soroush-ab/pebble/digital_twin/twin/web/meshes/yaw_shell.stl

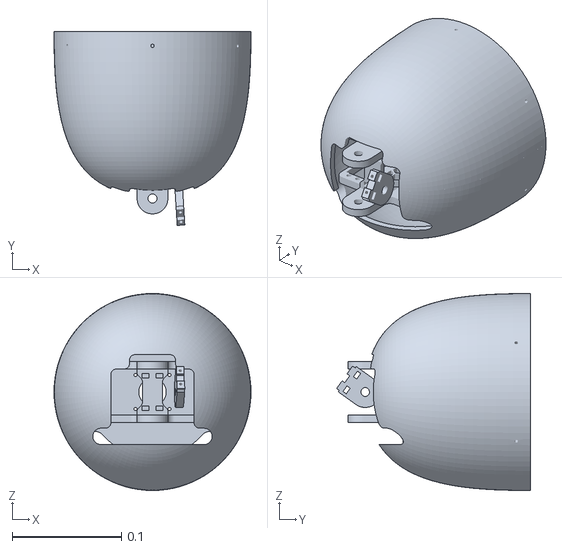
[picture p1: CAD file, 2026-10-13]
digital_twin/twin/web/meshes/yaw_shell.stl
0.18 x 0.177 x 0.18
