soroush-ab/pebble/digital_twin/twin/web/meshes/pitch_shell.stl

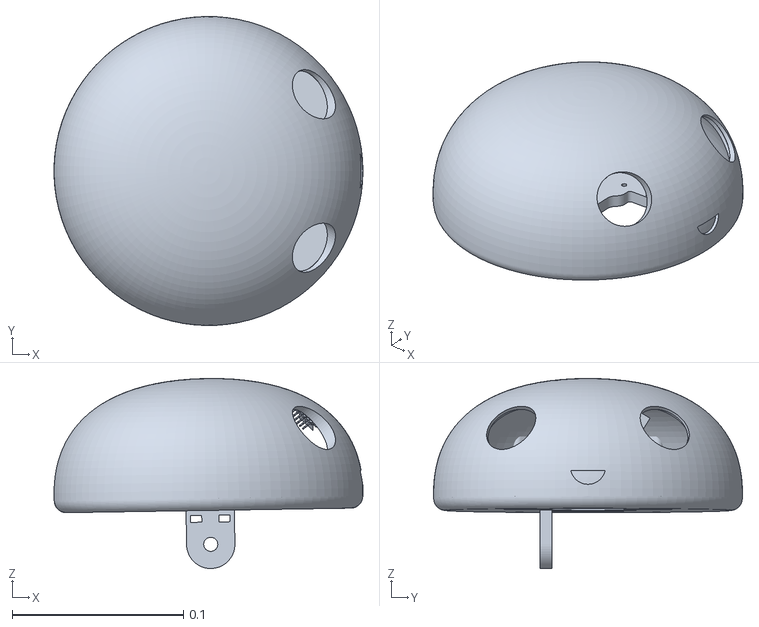
[picture p2: CAD file, 2026-10-13]
digital_twin/twin/web/meshes/pitch_shell.stl
0.18 x 0.18 x 0.111
