soroush-ab/pebble/digital_twin/twin/web/meshes/yaw_internal.stl

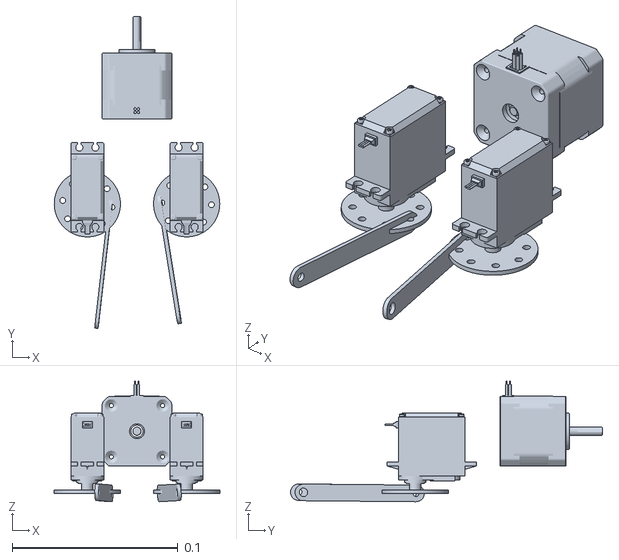
[picture p3: CAD file, 2026-10-13]
digital_twin/twin/web/meshes/yaw_internal.stl
0.1 x 0.188 x 0.0728
