soroush-ab/pebble/digital_twin/twin/web/meshes/roll_internal.stl

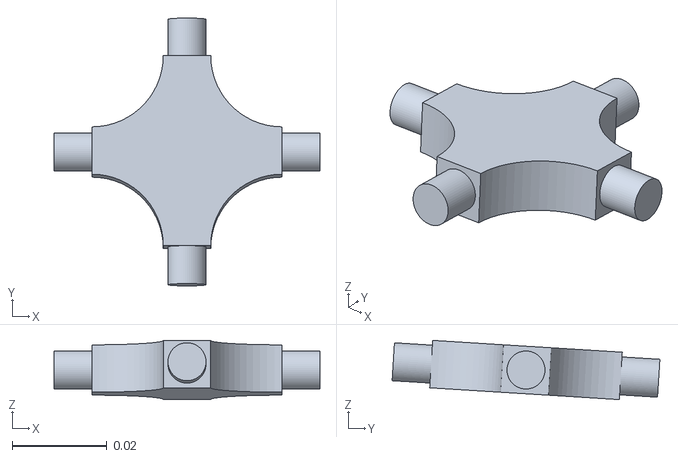
[picture p4: CAD file, 2026-10-13]
digital_twin/twin/web/meshes/roll_internal.stl
0.056 x 0.0564 x 0.0125
