soroush-ab/pebble/digital_twin/twin/web/meshes/pitch_internal.stl

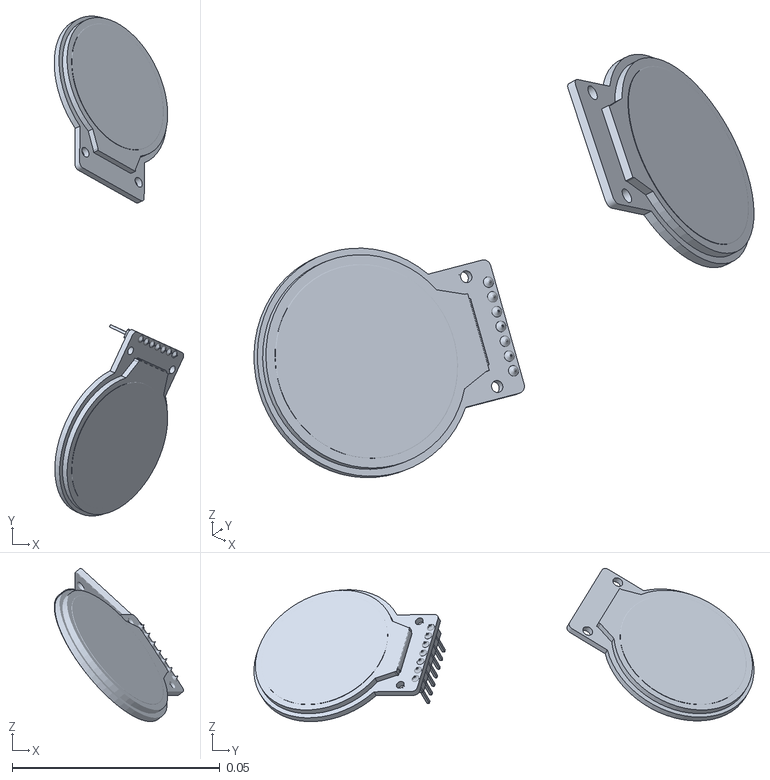
[picture p5: CAD file, 2026-10-13]
digital_twin/twin/web/meshes/pitch_internal.stl
0.0312 x 0.12 x 0.0369
