soroush-ab/pebble/digital_twin/twin/web/meshes/base_shell.stl

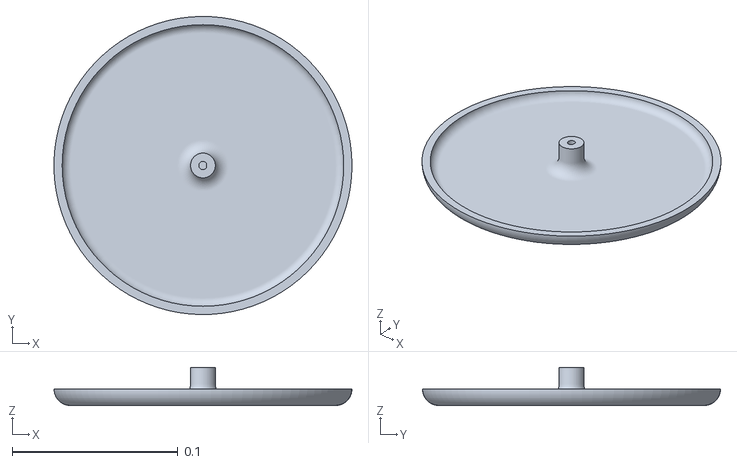
[picture p6: CAD file, 2026-10-13]
digital_twin/twin/web/meshes/base_shell.stl
0.18 x 0.18 x 0.023
