soroush-ab/pebble/(commit log)

2026-10-07 Add TTS, mic input, HTTP service and hardware-based model choice to speech
    - stt.py: model "auto" picks by hardware (GPU -> medium.en-q5_0, 8+ core
    CPU -> small.en-q5_1, otherwise base.en-q5_1), threads capped at 4;
    transcribe() takes numpy (+sample_rate), audio file bytes or a path;
    --mic push-to-talk with --save-dir / --input-device; collapses repeated
    sentences; models download atomically (a half-downloaded model used to
    segfault).
    - tts.py + voices.json: local Piper TTS with one voice/speed per LLM1
    character_id, extraversion-based speed for unlisted characters.
    - server.py: stdlib HTTP service (POST /stt, POST /tts, GET /health) so
    the robot, Home Assistant or the LLM pipe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
2026-10-11 Add digital twin, Russell emotions
    [robot.yaml]
2026-10-13 Retune Marvin's motion to match High-E, not the OCEAN value
    soshi's first-cut motion_profile for Marvin tested as slow/reluctant,
    mismatched against his High Extraversion (5.8) in the OCEAN table —
    the same value the Week-5 deck and LLM1's seed data use. Three signals
    pointed toward recategorizing Marvin as Low-E instead (soshi's own
    _review flag, his INTP typing on fan personality sites, the motion
    read itself), but moving him to Low-E would collide with Baymax on
    the course's single-axis-differentiation rule and unwind the Section 2
    rationale already built for the first presentation.
    Team decision: keep Extraversion High, retune motion to match instead.
    speed_scale 0.85->1.1, amplitude_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
2026-10-13 Commit baked twin model
    [base_shell.stl, pitch_internal.stl, pitch_shell.stl, roll_internal.stl, yaw_internal.stl, yaw_shell.stl]
2026-10-13 Drive the real robot from the twin
    [robot_hw.yaml]
2026-10-13 Initial firmware
    [partitions.csv]
2026-10-13 Eye frame player, I2S fix
    [disp.c, disp.h, frames.c, frames.h, main.c, mic_i2s.c, proto.h]
2026-10-14 Calibrate character voice speeds: Baymax was faster than Marvin
    Each Piper voice has its own natural pace, so the hand-picked
    length_scale values gave the opposite of the design: measured over 24
    real LLM2 replies, Baymax (Low E) spoke at ~202 wpm and Marvin (High E)
    at ~161 wpm.
    Recalibrated per voice against the speaking rates Nass & Lee (2001) used
    for synthetic introvert/extrovert voices (184 / 216 wpm, 200 between):
    Baymax 1.2 -> 1.35 (~186 wpm), R2-D2 1.0 -> 0.85 (~199), Marvin
    0.9 -> 0.66 (~213); extraversion fallback Low/Medium/High 0.98/0.85/0.77.
    README documents the method so it can be re-measured if a voice changes.
2026-10-14 Recalibrate voice speeds on articulation rate, not words per minute
    Words per minute including pauses turned out to be unreliable for
    comparing voices: it swings with sentence length and with each voice's
    pause length (alan pauses longer than ryan), so the previous values left
    R2-D2 almost as fast as Marvin and Baymax no slower than Marvin on long
    sentences.
    Now measured as syllables per second with silent frames removed, median
    over the 24 real LLM2 replies, keeping Nass & Lee's 184 : 200 : 216 ratio
    anchored on Marvin: Baymax 1.26 (~5.0 syl/s), R2-D2 1.0 (~5.5),
    Marvin 0.66 (~5.9); fallback Low/Medium/High 1.15/1.0/0.83.
